napiza/PSU/Schematic_PCB.pdf

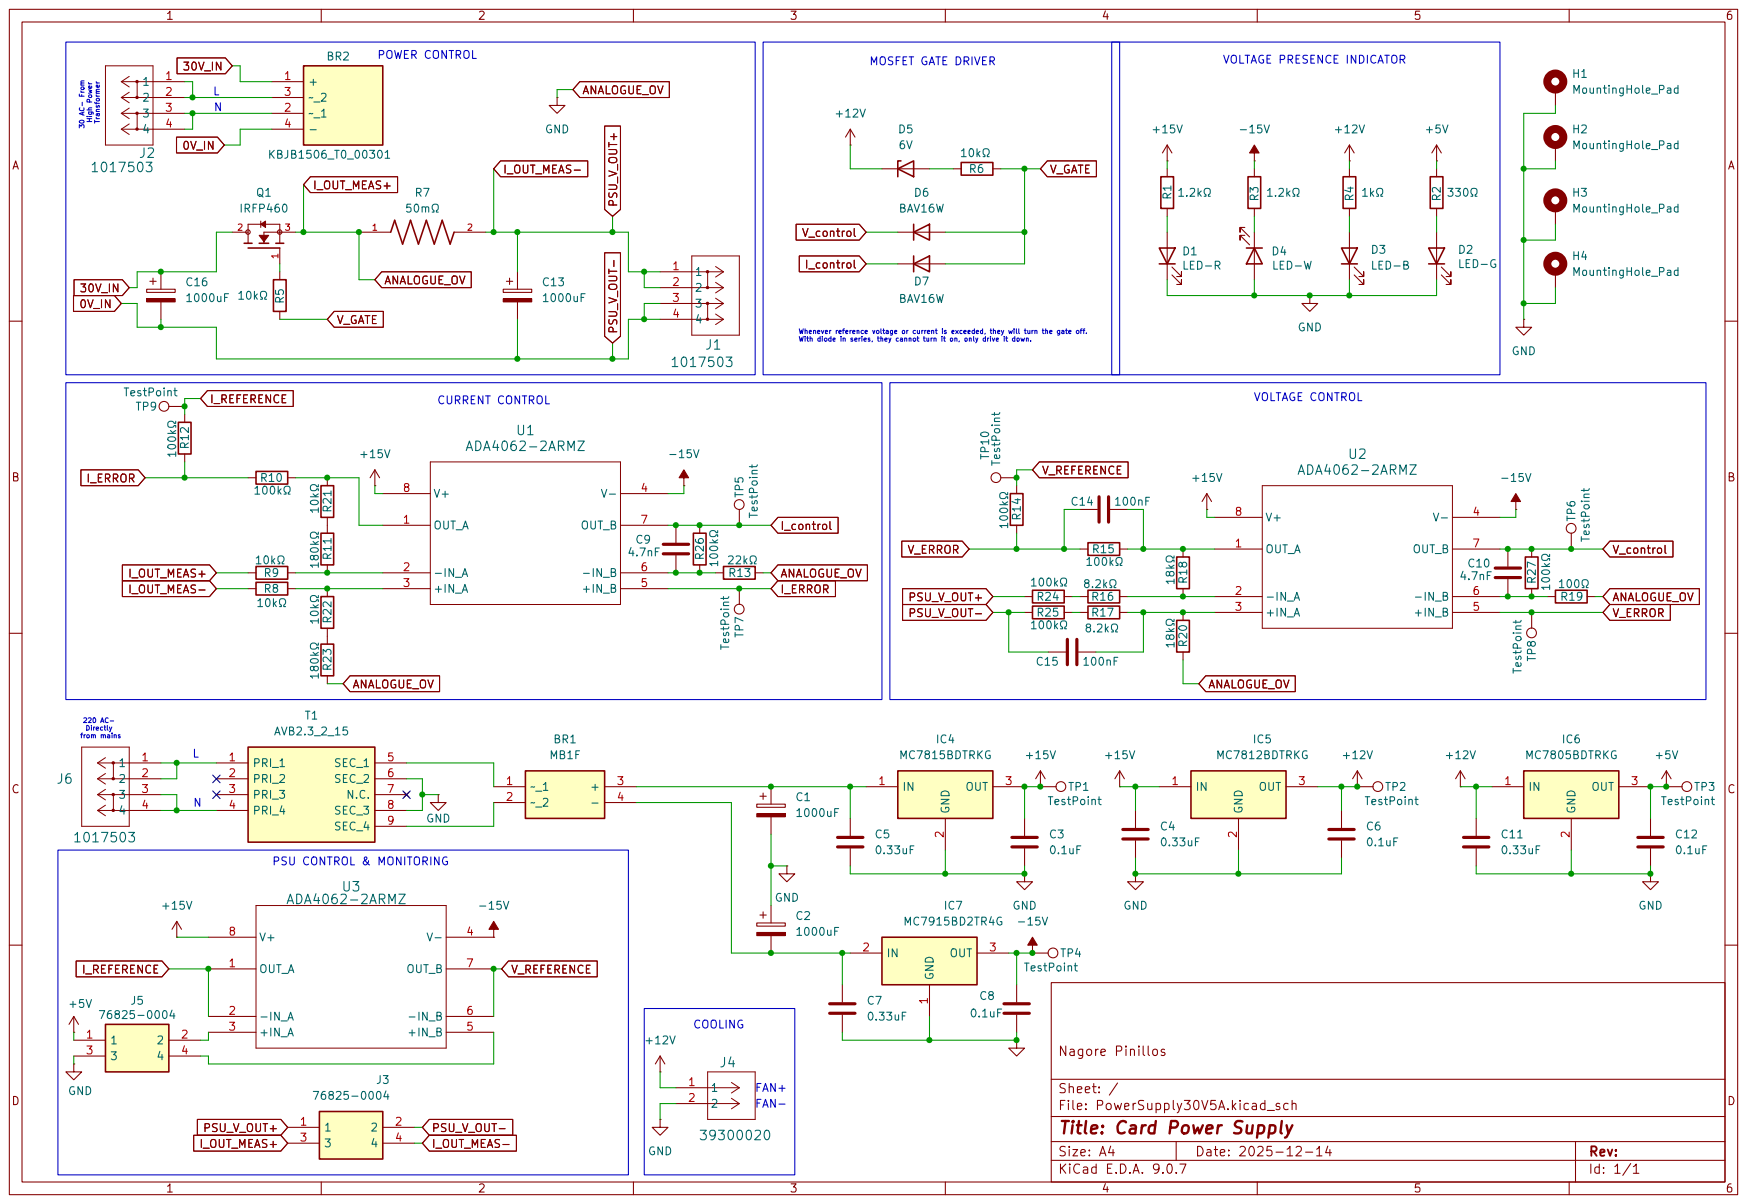
[picture p1: page 1]
