napiza/PSU/Schematic_PCB_2.pdf

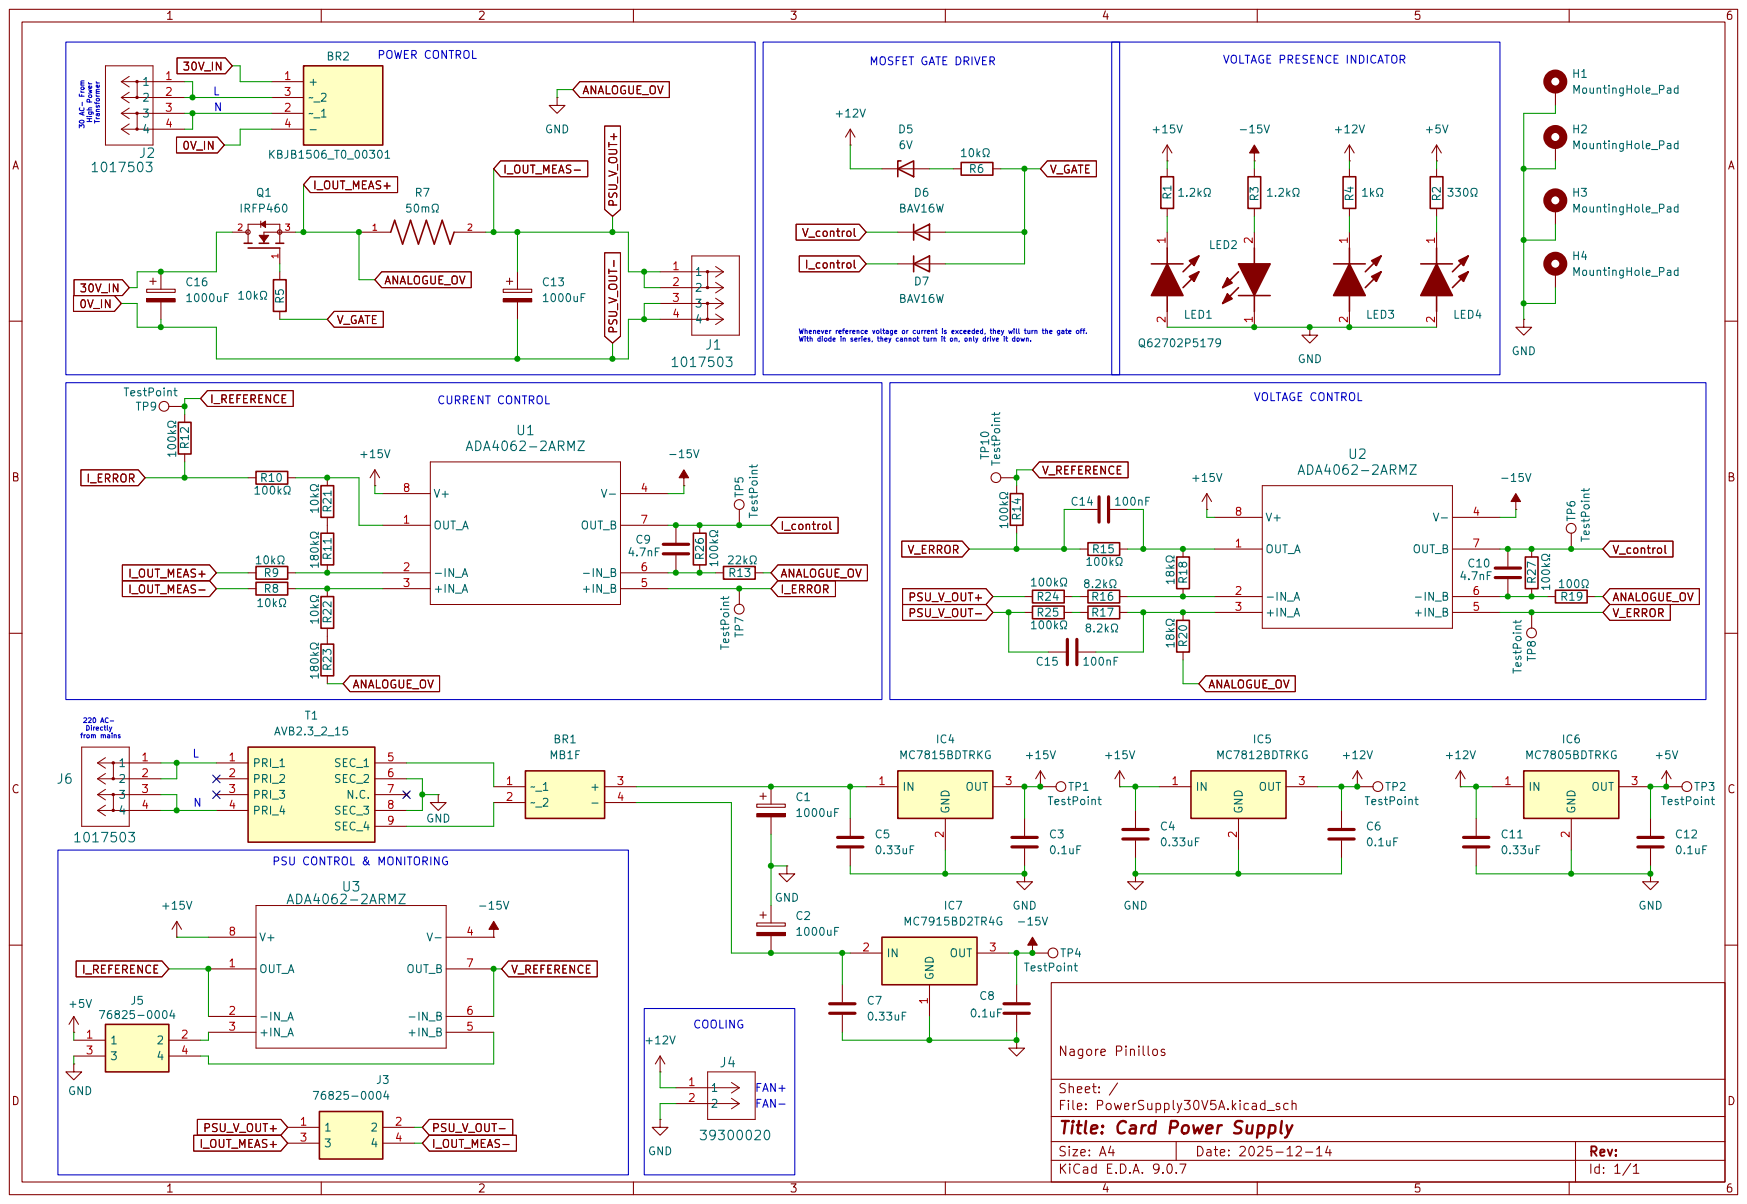
[picture p2: page 1]
