napiza/PSU/ControlSimulation_TOTAL_WORKING.asc

C1: cap; 4.7n
C2: cap; 100n
C3: cap; 4.7n
D1: diode
D2: diode
M1: nmos; IPB055N03L
R1: res; 10K
R2: res; 108.2k
R3: res; 108.2k
R4: res; 10K
R5: res; 18.018k
R6: res; 18.018k
R7: res; 100k
R8: res; 100k
R9: res; 100
R10: res; 10K
R11: res; 10k
R12: res; 10k
R13: res; 1Mega
R14: res; 190k
R15: res; 100k
R16: res; 100k
R17: res; 22k
R_load: res; 5
R_sensing: res; 50m
U1: UniversalOpAmp1
U2: UniversalOpAmp1
U3: UniversalOpAmp1
U4: UniversalOpAmp1
V1: voltage; 30
V2: voltage; 6
V3: voltage; PWL(0 -10 10 10)
V4: voltage; 5
V5: voltage; 12
V6: voltage; -12
V8: voltage; PWL(0 0 0.5 2.5)
Named nets: 30V_unregulated, 0, V_laod, V_gate, Ana_0V, V_gate_unregulated, I_control, V_control_test, Vcc+, Vcc-, V_ref, V_meas, V_diff, V_control, V_meas+, V_meas-, I_meas+, I_meas-, I_ref, I_diff, I_meas
.tran 0 10 0 1E-4
V_control=10V; Diode does not conduct; 6V into the V_gate;MOSFET closed; 30V in the load
V_control=-10V; Diode conduct; -9.3V(10V-0.7) into the V_gate;MOSFET open;0V in the load
In R1, it drops difference voltage (-9.3)-6=-15V
With PULSE in V_control
With PWL ramp in V_control
Para este MOSFET: La region lineal esta entre 1.4-1.8V: Antes completamente abierto, despues, completamente cerrado
La pregunta: yo estoy jugando con la region lineal? 0 estoy encendiendo y apagando (como un calentador); En ese caso? Tengo una frecuencia fija? O no?
Para esto, poner en lazo abierto control de voltaje
V_diff= 30/0V out==>-5/0V
When:
V_out=0=V_meas && V_ref=5V; V_diff=2.5 (Is basically a voltage divider)
V_out=30;V_meas=-5V && V_ref=5V: V_diff=0
Therefore,from here I can assume that, when
V_out<<V_ref--> V_diff will be high, diode will not conduct (will not bring V_gate down), and MOSFET will be closed so that output conducts
Question is? Does it treat this MOSFET as a switch or a resistor?
.option gminsteps=0
Without resistor in parallel with capacitor for integrator op-amp, output saturates
TO BE TESTED: If I have 100R here in the integrator, I am injecting for some reason voltage in Analog_O= And offseting output at the beginning?
Conclusion= When I closed the the loop was not the case anymore
CONCLUSION: It acts in the linear region of the MOSFET: MOSFET is not switching
The maximum voltage in V_diff is going to be 2.5V (So it does not saturate mosfet)
Voltage in the output of the integrator just control dv/dt, does not saturate to voltage rate
To be done next: Add current loop
V_LOOP
I_diff= 5/0A out ==>-5/0V
        250mV/0V ==>-5/0V
TODO: Calculate time constant here
To be done next: Understand Analog 0V floating @ rail voltage
G=20
G=0.167
Again=Without resistor it saturates: In simulation even to kV
Of course, ouput will only achieve 5A within circuit limit and at load conditions
30/5A=Only bellow 6 Ohm
Question= If I put 5 Ohm resistor, with only I_loop connected, output only goes up to 5V,
and not allowing it to go 30V and 5A  ==> This for some reason depends in the resistor that I 
put in the (I_loop) integrator feedback (parallel to Capacitor).
With 10k it does not allow output of integrator to go higher than 2.15V
With 600k it goes up to 2.28V
As we are playin in the linear region, is very sensitive to these voltages
V_LOOP
