napiza/PSU/PowerSupply30V5A.kicad_pcb

## KiCad design PowerSupply30V5A.kicad_pcb (2026-11-08)

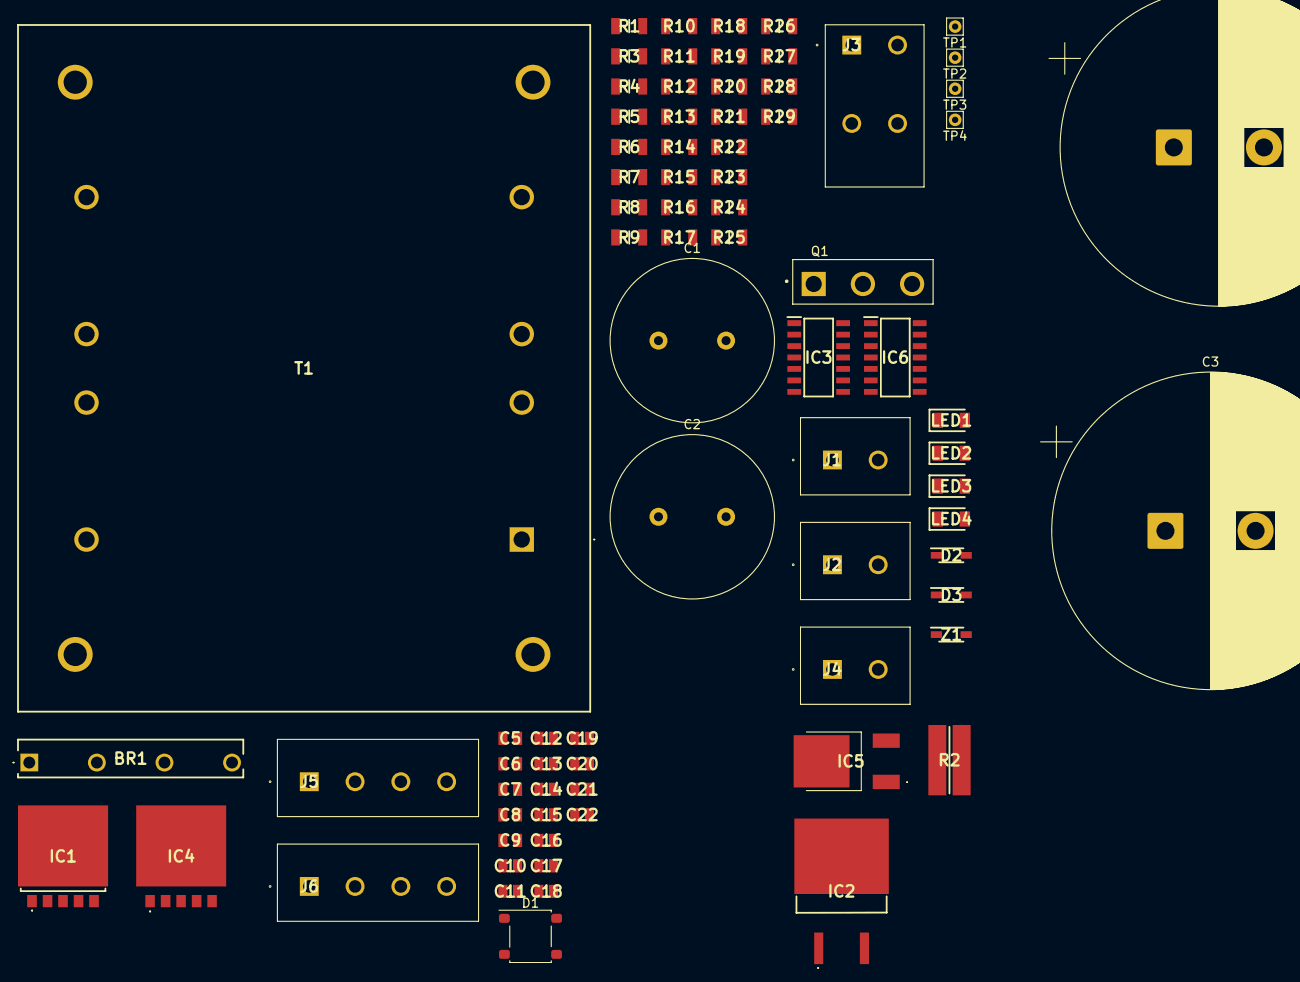
[picture p3: board PowerSupply30V5A.kicad_pcb from above]

Board: 2 copper layers, 78 parts (0 on the bottom side), 28 nets, no tracks yet.

Parts:
BR1: KBJB1506_T0_00301
C1, C2: 1000uF; C_Radial_D18.0mm_H35.5mm_P7.50mm
C3, C4: 12000uF; CP_Radial_D35.0mm_P10.00mm_SnapIn
C5, C10, C11, C12, C14, C17, C22: 1μF_25V; CAPC2012X94N
C6, C15: 330nF_25V; CAPC2012X94N
C7, C8, C13, C16, C21: 100nF_50V; CAPC2012X94N
C9, C20: 4.7uF_25V; CAPC2012X94N
C18, C19: 4.7nF_50V; CAPC2012X94N
D1: Bridge_1ph; P34_SO-DIL-ABS
D2, D3: 1N4150W-E3-18; SOD3716X135N
IC1: BDJ5FD0WHFP-TR; BDJ5FD0WHFPTR
IC2: MC7915BD2TR4G
IC3, IC6: LF247DT; SOIC127P600X175-14N
IC4: BDJ2FD0WHFP-TR; BDJ2FD0WHFPTR
IC5: MC7805BDTRKG; LM317MADTRKG
J1, J2, J4: 1755736
J3: 1017503
J5, J6: 1755752
LED1, LED2, LED3, LED4: CMD15-21VGD_TR8; LEDC3215X130N
Q1: IRFP460; TO546P1587X531X2511-3
R1, R3, R9, R12, R13, R19: 10kΩ; RESC3216X60N
R2: FCSL76R050DER; RESC3876X70N
R4, R5, R17, R18, R20, R21, R23, R24: 100kΩ; RESC3216X60N
R6, R7: 8.2kΩ; RESC3216X60N
R8, R10: 180kΩ; RESC3216X60N
R11, R15: 18kΩ; RESC3216X60N
R14, R16: 0Ω; RESC3216X60N
R22: 22kΩ; RESC3216X60N
R25: 100Ω; RESC3216X60N
R26, R27: 620Ω; RESC3216X60N
R28: 470Ω; RESC3216X60N
R29: 130Ω; RESC3216X60N
T1: 14A-56-28; 14A5628
TP1, TP2, TP3, TP4: TestPoint; Pin_D0.7mm_L6.5mm_W1.8mm_FlatFork
Z1: 6V; SOD3716X135N

Connections:
0V_IN: BR1.4 (-), C1.2, C2.2, J3.3, J3.4
30V_IN: BR1.1 (+), C1.1, Q1.2
+5V: IC5.3 (OUT), J5.4, TP3.1
+12V: IC4.4 (VO), IC5.1 (IN), J4.1, TP4.1, Z1.1 (K)
+15V: IC1.4 (VO), IC3.4 (V+), IC4.1 (CTL), IC4.2 (VCC), IC6.4 (V+), TP1.1
-15V: IC2.3 (OUT), IC3.11 (V-), IC6.11 (V-), TP2.1
ANALOGUE_OV: C3.2, C4.1, IC1.3 (GND), IC1.6 (FIN), IC2.1 (GND), IC4.3 (GND), IC4.5 (N.C._), IC4.6 (FIN), IC5.2 (GND), J4.2, J5.1, J6.2, J6.4, LED1.2 (A), LED2.1 (K), LED3.2 (A), LED4.2 (A), Q1.3, R2.1, T1.9, T1.10
I_MEAS: IC3.1, IC6.10 (+)
I_OUT_MEAS-: C2.1, J3.1, J3.2, R2.2
I_REFERENCE: IC6.1, IC6.2 (-)
I_control: D3.1 (K), IC3.8
unnamed: BR1.2 (~_1), J2.2
unnamed: BR1.3 (~_2), J2.1
unnamed: C4.2, D1.2 (-), IC2.2 (IN)
unnamed: C3.1, C5.2, D1.1 (+), IC1.1 (CTL), IC1.2 (VCC)
unnamed: D1.3, T1.7
unnamed: D1.4, T1.12
unnamed: IC6.3 (+), J5.3
unnamed: IC6.5 (+), J5.2
unnamed: IC6.8, IC6.9 (-), J6.1
unnamed: IC6.13 (-), IC6.14, J6.3
unnamed: J1.1, T1.1
unnamed: J1.2, T1.6
unnamed: T1.3, T1.4
V_GATE: D2.2 (A), D3.2 (A)
V_MEAS: IC3.7, IC6.12 (+)
V_REFERENCE: IC6.6 (-), IC6.7
V_control: D2.1 (K), IC3.14
