napiza/PSU/(commit log)

2026-05-25 upload files from local
    [PowerSupply30V5A.csv, PowerSupply30V5A.kicad_pcb, PowerSupply30V5A.kicad_sch, PowerSupply30V5A_BOM - correction.csv, PowerSupply30V5A_BOM.csv]
2026-08-19 Starting v2 of pcb
2026-08-19 Starting v2
    [PowerSupply30V5A.kicad_sch]
2026-08-23 Updates following steps
    [PowerSupply30V5A.kicad_sch]
2026-08-23 Added LDO symbol with synch
    [PowerSupply30V5A.kicad_sch]
2026-08-26 Added -15V LDO
    [PowerSupply30V5A.kicad_sch]
2026-08-26 Added additional todo
    [PowerSupply30V5A.kicad_sch]
2026-08-28 Added 5V and 12 V LDO, started with mosfet side, corrected 50mOhm resistor
    [PowerSupply30V5A.kicad_sch]
2026-08-31 Advanced in power mosfet stage
    [PowerSupply30V5A.kicad_sch]
2026-09-02 Continued with Power MOSFET STAGE
    [PowerSupply30V5A.kicad_sch]
2026-09-02 Added few comments for next steps
    [PowerSupply30V5A.kicad_sch]
2026-09-04 continued adding resistors
    [PowerSupply30V5A.kicad_sch]
2026-09-05 Updated voltage monitoring+voltage control , started with opamp selection
    [PowerSupply30V5A.kicad_sch]
2026-09-06 Added control
    [PowerSupply30V5A.kicad_sch]
2026-09-06 Updated comments
    [PowerSupply30V5A.kicad_sch]
2026-09-07 Started thinking about sending measurement to PSU_monitoring PCB
    [PowerSupply30V5A.kicad_sch]
2026-09-15 Finished reference +measurement buffers+fan--> next step: power from trafo+rectifier calculate
    [PowerSupply30V5A.kicad_sch]
2026-09-19 Added 1uF capacitors, change the rest of capacitor by copy pasting (like done for resistors
    [PowerSupply30V5A.kicad_sch]
2026-09-20 Substituted all the capas for my library
    [PowerSupply30V5A.kicad_sch]
2026-09-20 Calculated power comsumption by +5V and +12V rails
    [PowerSupply30V5A.kicad_sch]
2026-10-04 Missing current measurement of the fan to finish calculating power
2026-10-05 Measured fan current
2026-10-31 Stage 45W rectifier + transformer corrected dimensioning in power, before was not able to provide
2026-10-31 Cleaned, started with PCB layout
2026-11-08 Limitted output to 28V, for keeping it cheap
2026-11-08 Corrected schematics
